suryasenthilr/TPU-8x8-systolic-core/pnr/apex_tpu_top_layout.png

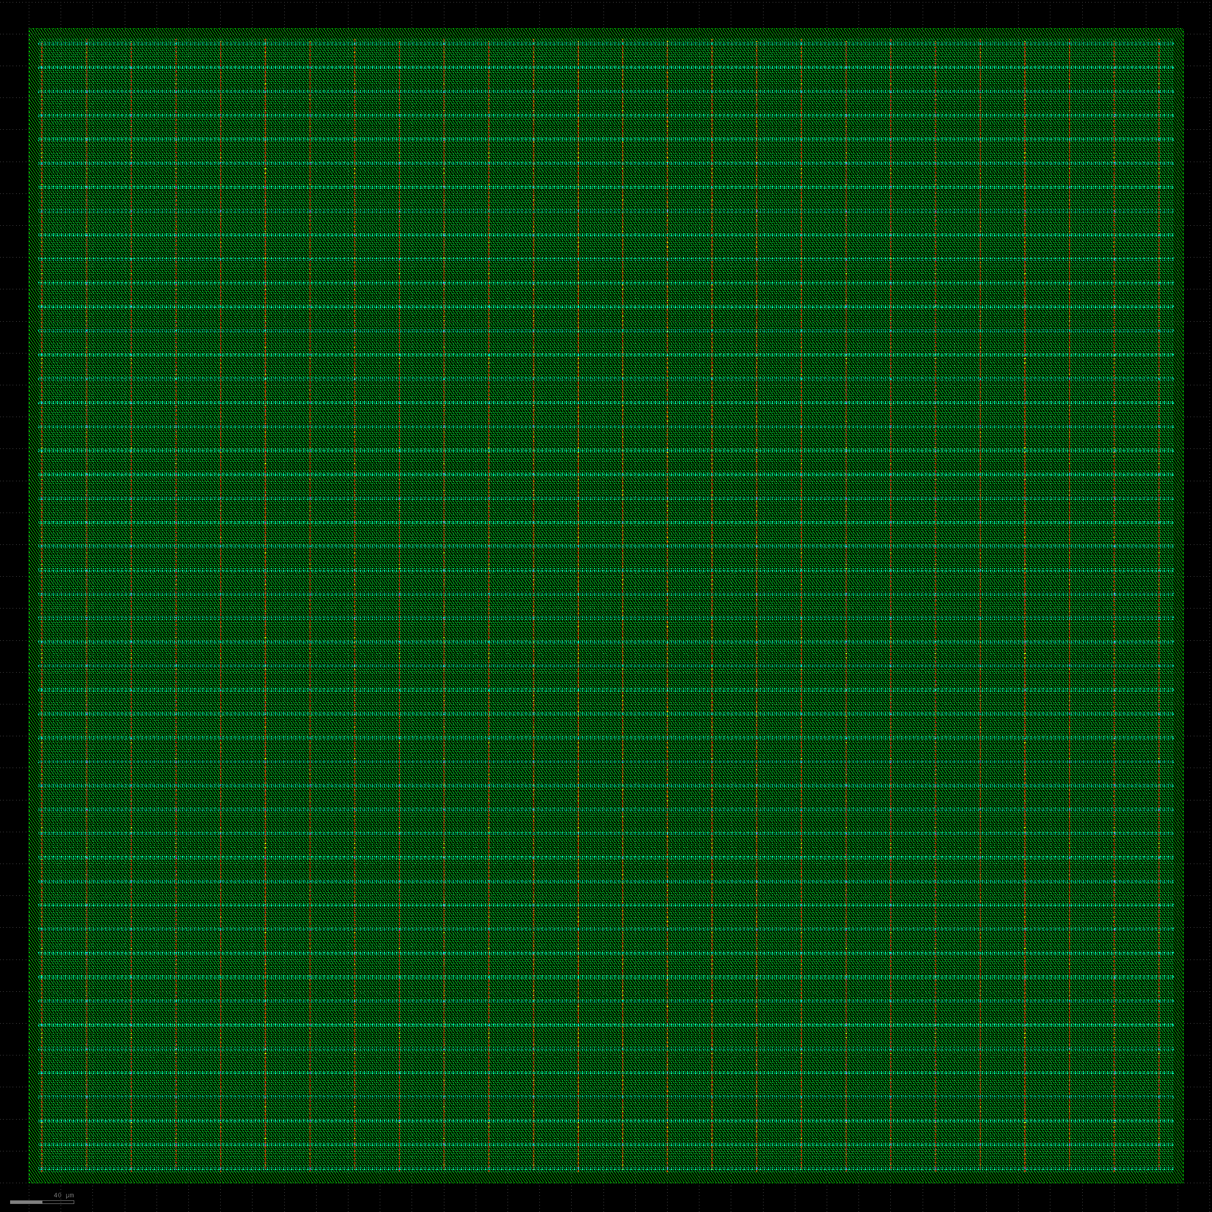
pnr/apex_tpu_top_layout.png
