suryasenthilr/TPU-8x8-systolic-core/pnr/systolic_array_layout.png

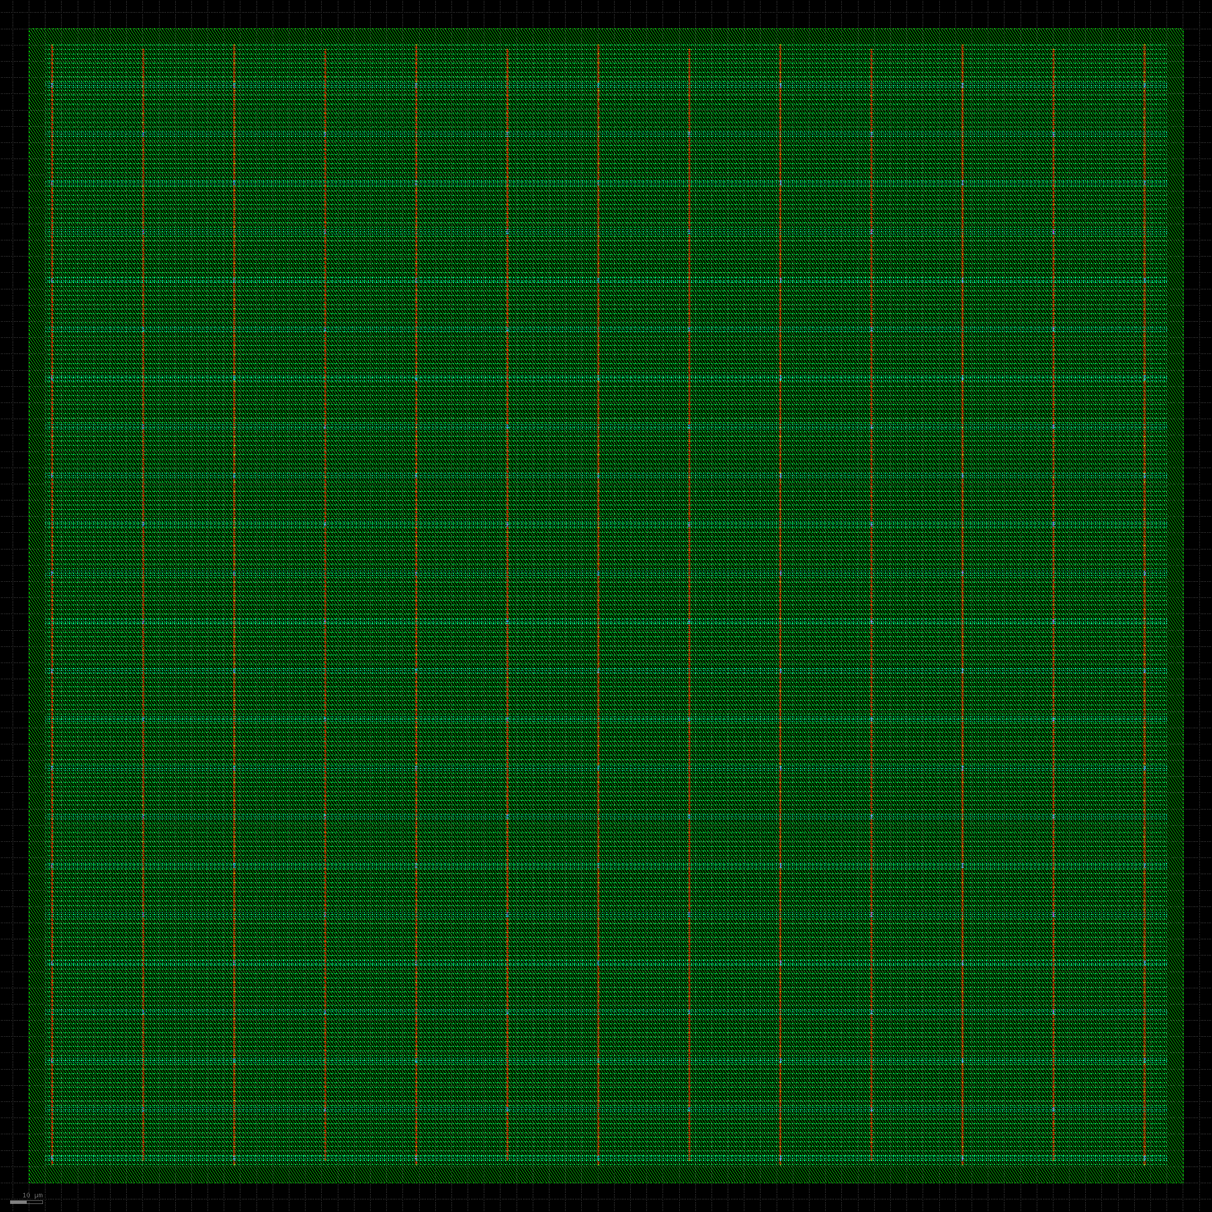
pnr/systolic_array_layout.png
