suryasenthilr/TPU-8x8-systolic-core/(commit log)

2026-11-05 Initial release: Apex-TPU 2D Systolic Array DL Accelerator (Nangate 45nm ASIC, 367.8 kGE)
2026-11-05 feat: complete Nangate 45nm physical design P&R, GDSII tapeout, and GUI layout visualizer
2026-11-05 docs: add multi-panel functional submodule floorplan and density heatmaps
